uzm99/ENCE4231_UnaiZurbano/2026_PhilsLab_PCBDesign/BOM/2026_PhilsLab_PCBDesign.csv

Reference | Qty | Value | DNP | Exclude from BOM | Exclude from Board | Footprint | Datasheet
C1,C2,C3,C4,C9 | 5 | 100n |  |  |  | Capacitor_SMD:C_0805_2012Metric
C5 | 1 | 10u |  |  |  | Capacitor_SMD:C_0805_2012Metric
C6 | 1 | 10n |  |  |  | Capacitor_SMD:C_0805_2012Metric
C7,C8 | 2 | 1u |  |  |  | Capacitor_SMD:C_0805_2012Metric
C10,C11 | 2 | 10p |  |  |  | Capacitor_SMD:C_0805_2012Metric
C12,C13 | 2 | 22u |  |  |  | Capacitor_SMD:C_0805_2012Metric
D1 | 1 | RED |  |  |  | LED_SMD:LED_0603_1608Metric
FB1 | 1 | 120R |  |  |  | Inductor_SMD:L_0603_1608Metric
J1 | 1 | USB_B_Micro |  |  |  | Connector_USB:USB_Micro-B_Wuerth_629105150521
J2,J3,J4 | 3 | Conn_01x04_Pin |  |  |  | Connector_PinHeader_2.54mm:PinHeader_1x04_P2.54mm_Vertical
R1 | 1 | 10k |  |  |  | Resistor_SMD:R_0402_1005Metric
R2,R3,R4,R5 | 4 | 1k5 |  |  |  | Resistor_SMD:R_0402_1005Metric
SW1 | 1 | SW_SPDT |  |  |  | Button_Switch_SMD:SW_SPDT_PCM12
U1 | 1 | STM32F103C8T6 |  |  |  | Package_QFP:LQFP-48_7x7mm_P0.5mm | https://www.st.com/resource/en/datasheet/stm32f103c8.pdf
U2 | 1 | AMS1117-3.3 |  |  |  | Package_TO_SOT_SMD:SOT-223-3_TabPin2 | http://www.advanced-monolithic.com/pdf/ds1117.pdf
Y1 | 1 | 16MHz |  |  |  | Crystal:Crystal_SMD_3225-4Pin_3.2x2.5mm
