uzm99/ENCE4231_UnaiZurbano/2026_PhilsLab_PCBDesign/components/WE_629105150521_CAD_files/Download_IGES_629105150521 (rev1).iges

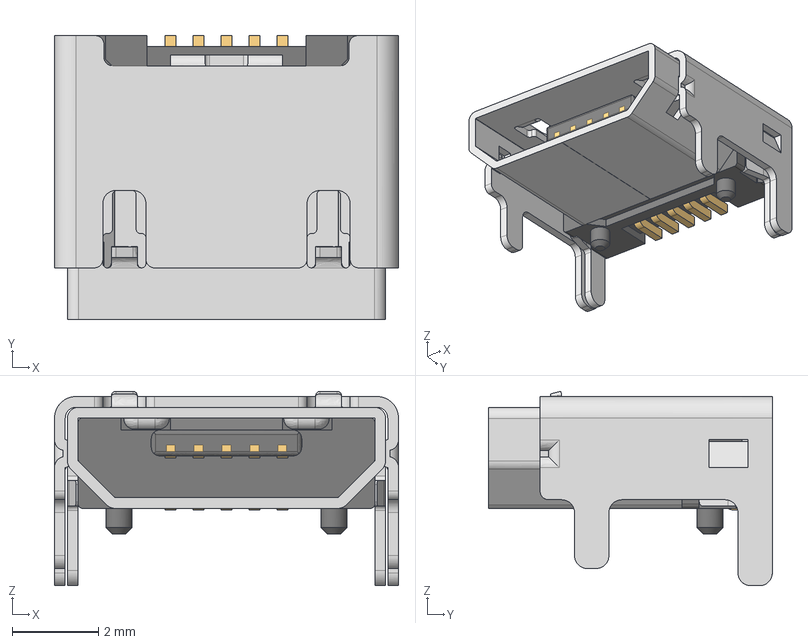
[picture p6: CAD file, 2026-04-28]
2026_PhilsLab_PCBDesign/components/WE_629105150521_CAD_files/Download_IGES_629105150521 (rev1).iges
8.00 x 6.60 x 4.52 mm
