uzm99/ENCE4231_UnaiZurbano/FinalProject_2WheelRobot/Projects/20260501_2Wheel_Balance_Robot/components/ESP8266-01_ESP-01/step/ESP8266-01_ESP-01.step

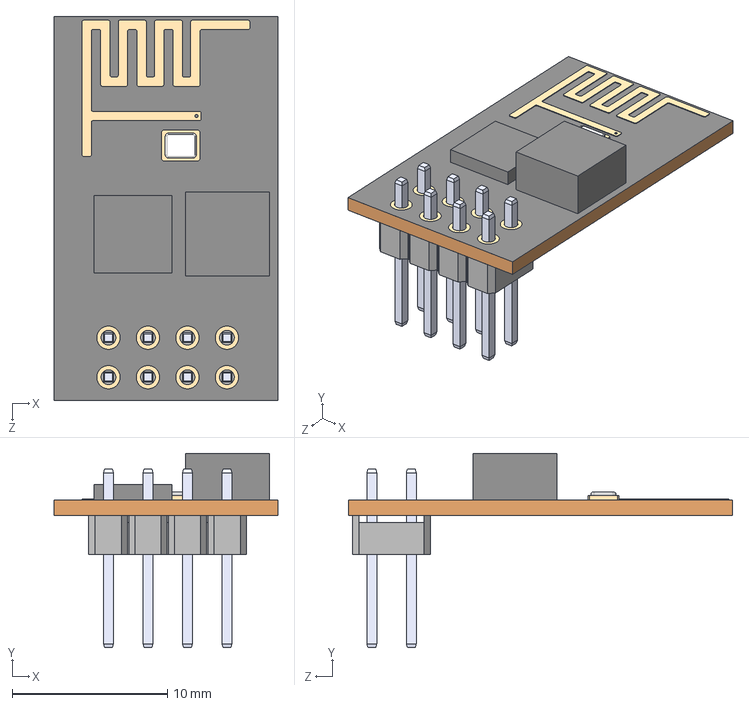
[picture p7: CAD file, 2026-04-23]
FinalProject_2WheelRobot/Projects/20260501_2Wheel_Balance_Robot/components/ESP8266-01_ESP-01/step/ESP8266-01_ESP-01.step
14.4 x 12.5 x 24.7 mm
