uzm99/ENCE4231_UnaiZurbano/FinalProject_2WheelRobot/Projects/20260501_2Wheel_Balance_Robot/components/Fuse_3DModel/MF-MSMF050-2--3DModel-STEP-56544.STEP

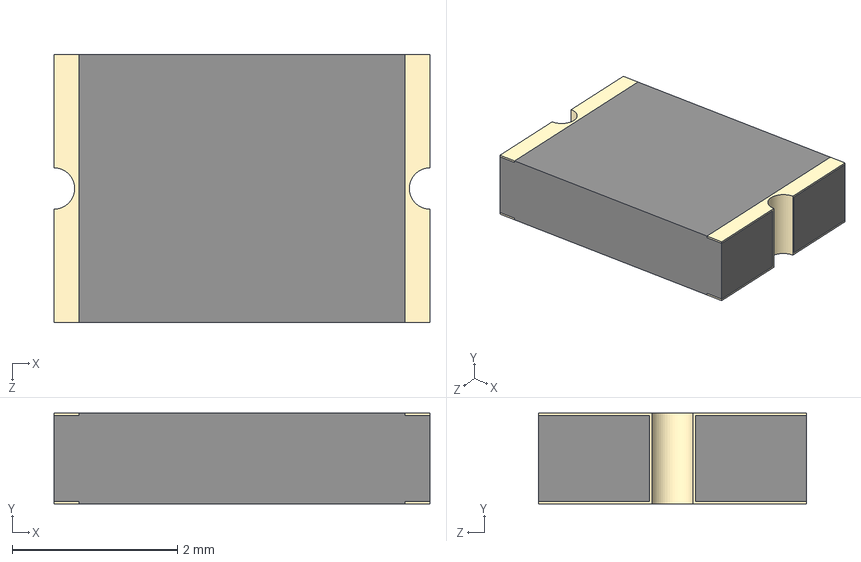
[picture p8: CAD file, 2026-04-23]
FinalProject_2WheelRobot/Projects/20260501_2Wheel_Balance_Robot/components/Fuse_3DModel/MF-MSMF050-2--3DModel-STEP-56544.STEP
4.55 x 1.10 x 3.24 mm
