uzm99/ENCE4231_UnaiZurbano/FinalProject_2WheelRobot/Projects/20260501_2Wheel_Balance_Robot/components/MPU6050/ITG-MPU.STEP

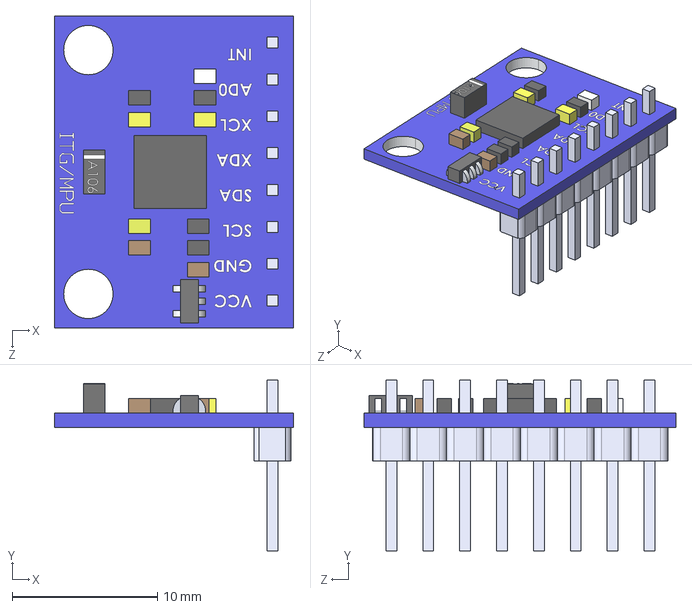
[picture p9: CAD file, 2026-04-23]
FinalProject_2WheelRobot/Projects/20260501_2Wheel_Balance_Robot/components/MPU6050/ITG-MPU.STEP
16.5 x 11.8 x 21.5 mm
8 Header-Pin
Placa_Base
