uzm99/ENCE4231_UnaiZurbano/FinalProject_2WheelRobot/Projects/20260501_2Wheel_Balance_Robot/components/SPDT_Slide_Switch/step/SLW-66527511-SMT-TR.step

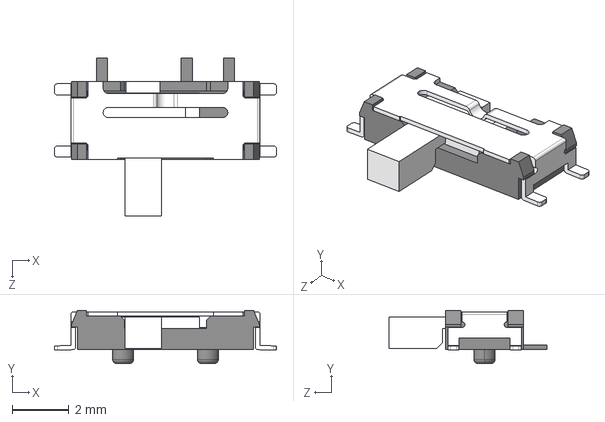
[picture p10: CAD file, 2026-04-23]
FinalProject_2WheelRobot/Projects/20260501_2Wheel_Balance_Robot/components/SPDT_Slide_Switch/step/SLW-66527511-SMT-TR.step
7.86 x 1.88 x 5.58 mm
