uzm99/ENCE4231_UnaiZurbano/FinalProject_2WheelRobot/Projects/20260501_2Wheel_Balance_Robot/components/SW_uP_Reset/step/SW_uP_Reset.stp

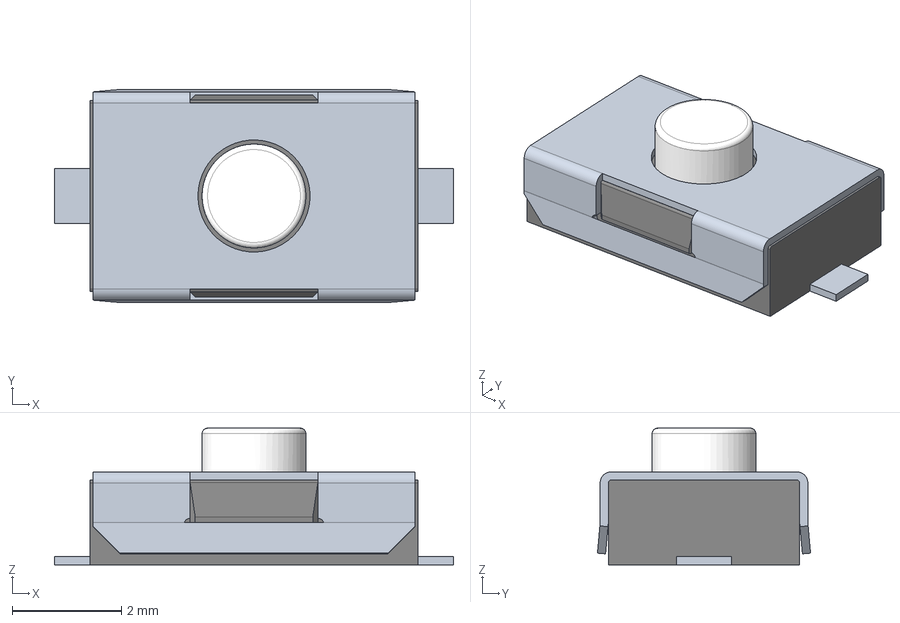
[picture p11: CAD file, 2026-04-23]
FinalProject_2WheelRobot/Projects/20260501_2Wheel_Balance_Robot/components/SW_uP_Reset/step/SW_uP_Reset.stp
7.30 x 3.90 x 2.50 mm
