uzm99/ENCE4231_UnaiZurbano/FinalProject_2WheelRobot/Projects/20260501_2Wheel_Balance_Robot/components/USB_C/step/Same_Sky_UJ20-C-H-C-4-SMT-TR.step

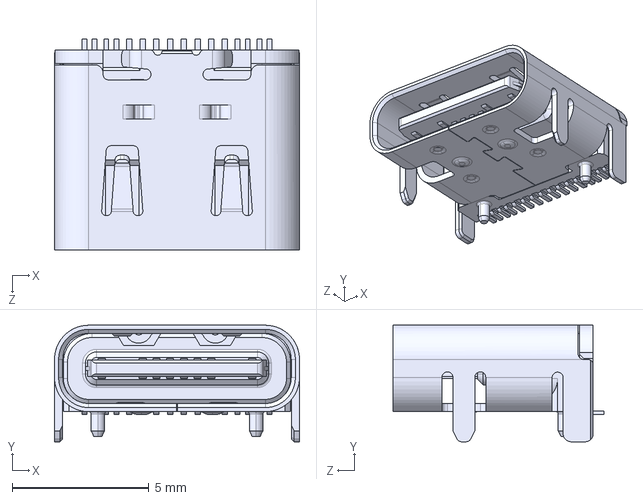
[picture p12: CAD file, 2026-04-30]
FinalProject_2WheelRobot/Projects/20260501_2Wheel_Balance_Robot/components/USB_C/step/Same_Sky_UJ20-C-H-C-4-SMT-TR.step
8.95 x 4.26 x 7.72 mm
