uzm99/ENCE4231_UnaiZurbano/(list of files, cad)

Other CAD files:
2026_PhilsLab_PCBDesign/components/WE_629105150521_CAD_files/629105150521 (rev1).stp
