uzm99/ENCE4231_UnaiZurbano/FinalProject_2WheelRobot/IMG/JST_soldered_encoder.jpeg

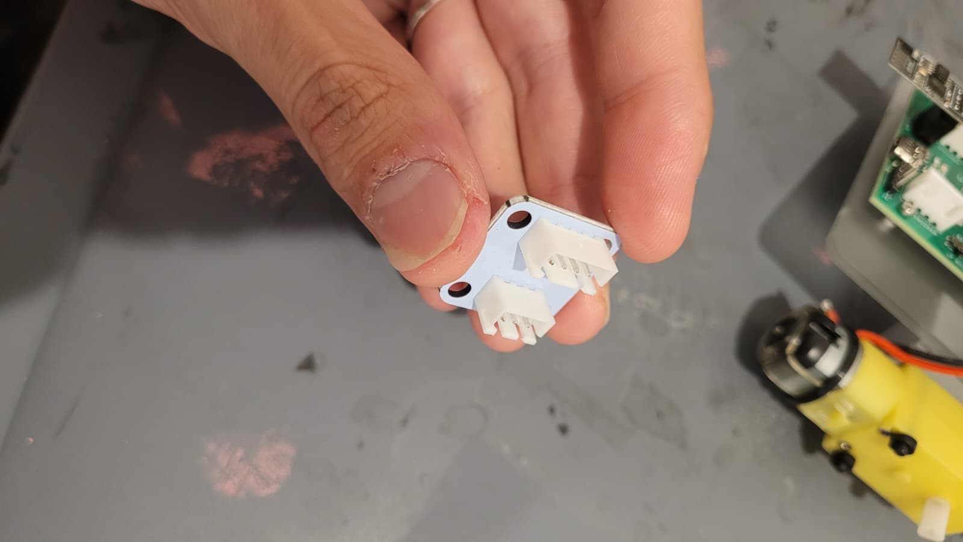
FinalProject_2WheelRobot/IMG/JST_soldered_encoder.jpeg
