uzm99/ENCE4231_UnaiZurbano/FinalProject_2WheelRobot/Projects/20260501_2Wheel_Balance_Robot/docs/20260501_Print PCB_Rev2.0.pdf

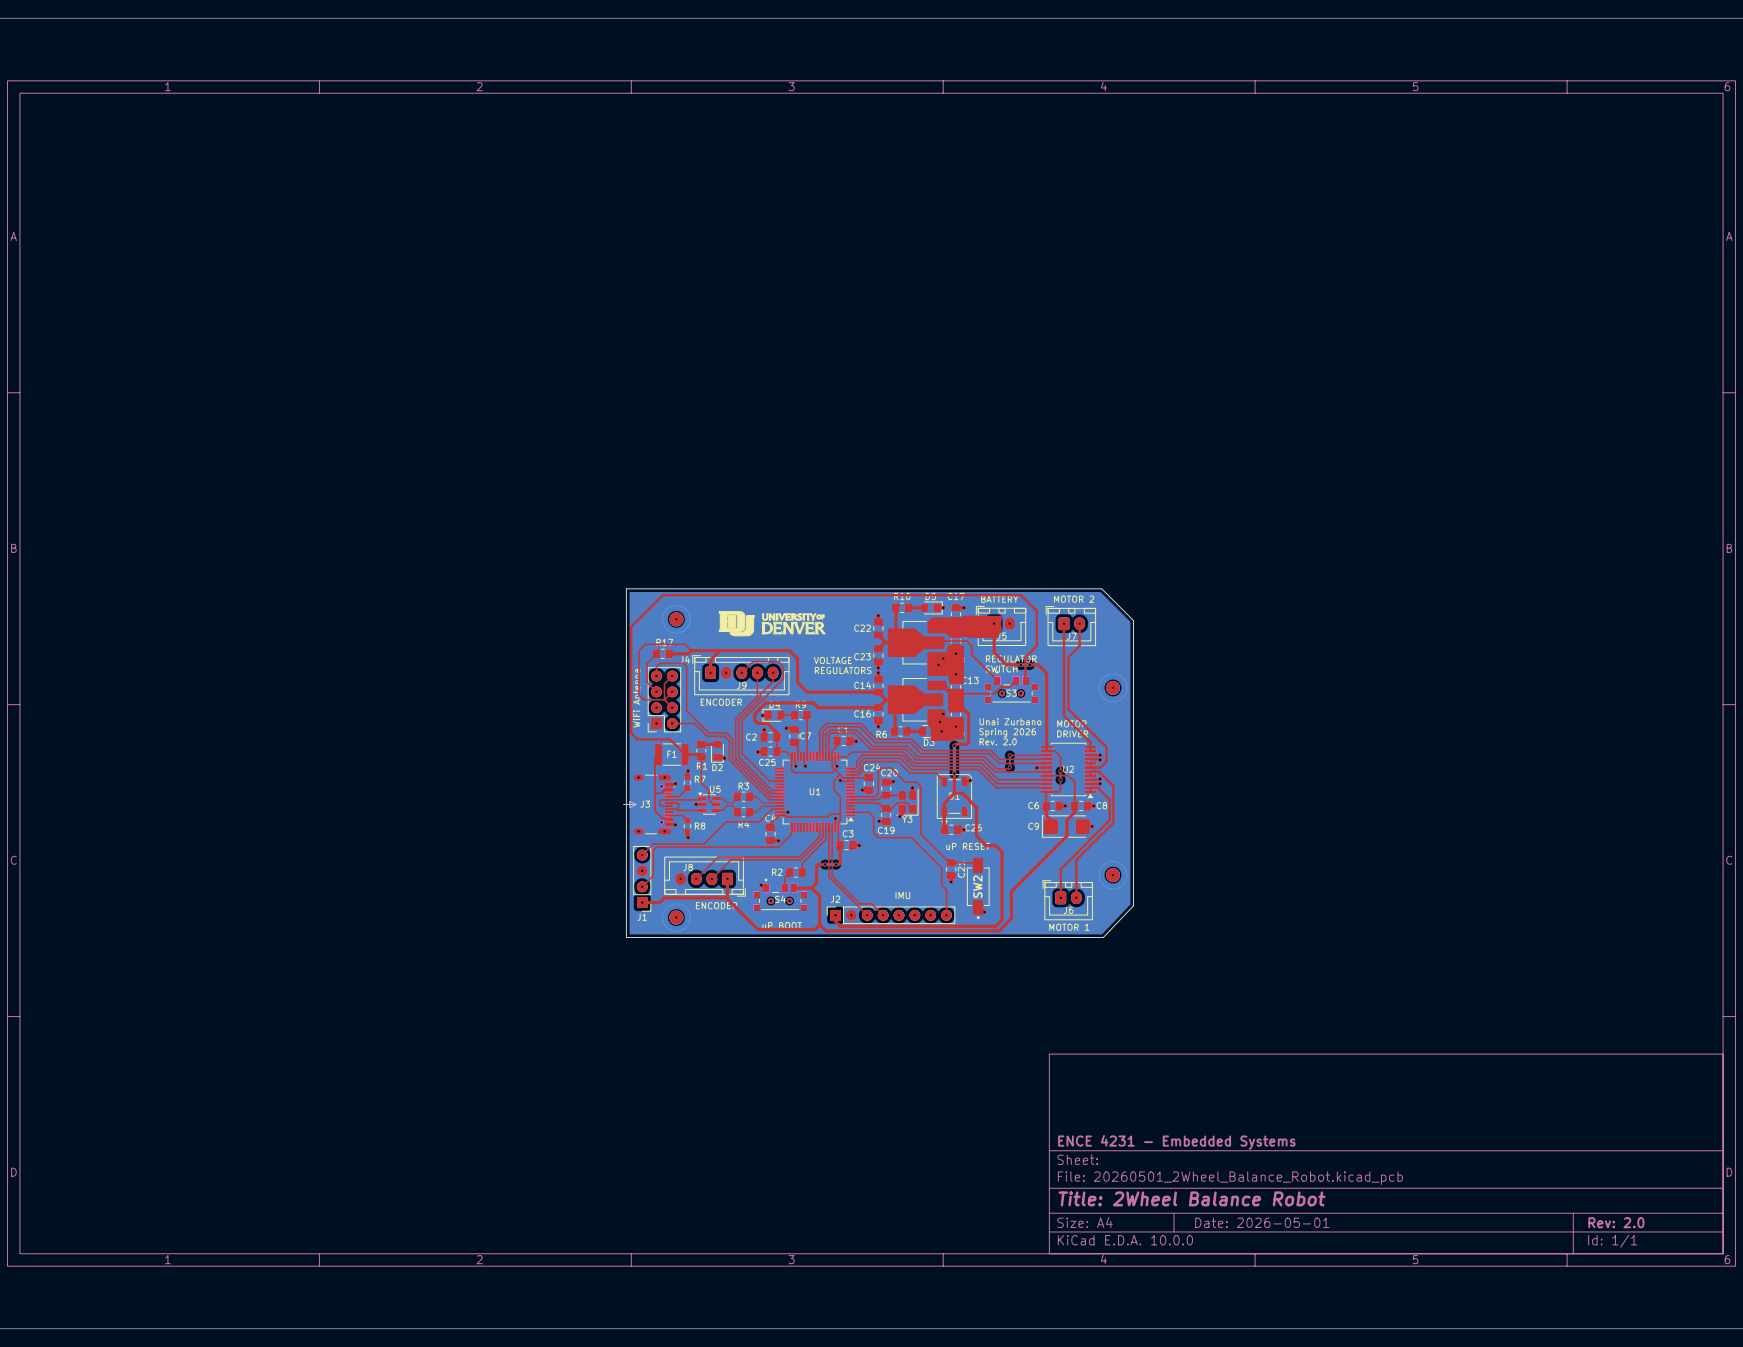
[picture p14: page 1]
