uzm99/ENCE4231_UnaiZurbano/FinalProject_2WheelRobot/Projects/20260501_2Wheel_Balance_Robot/docs/20260423_Print Schematic.pdf

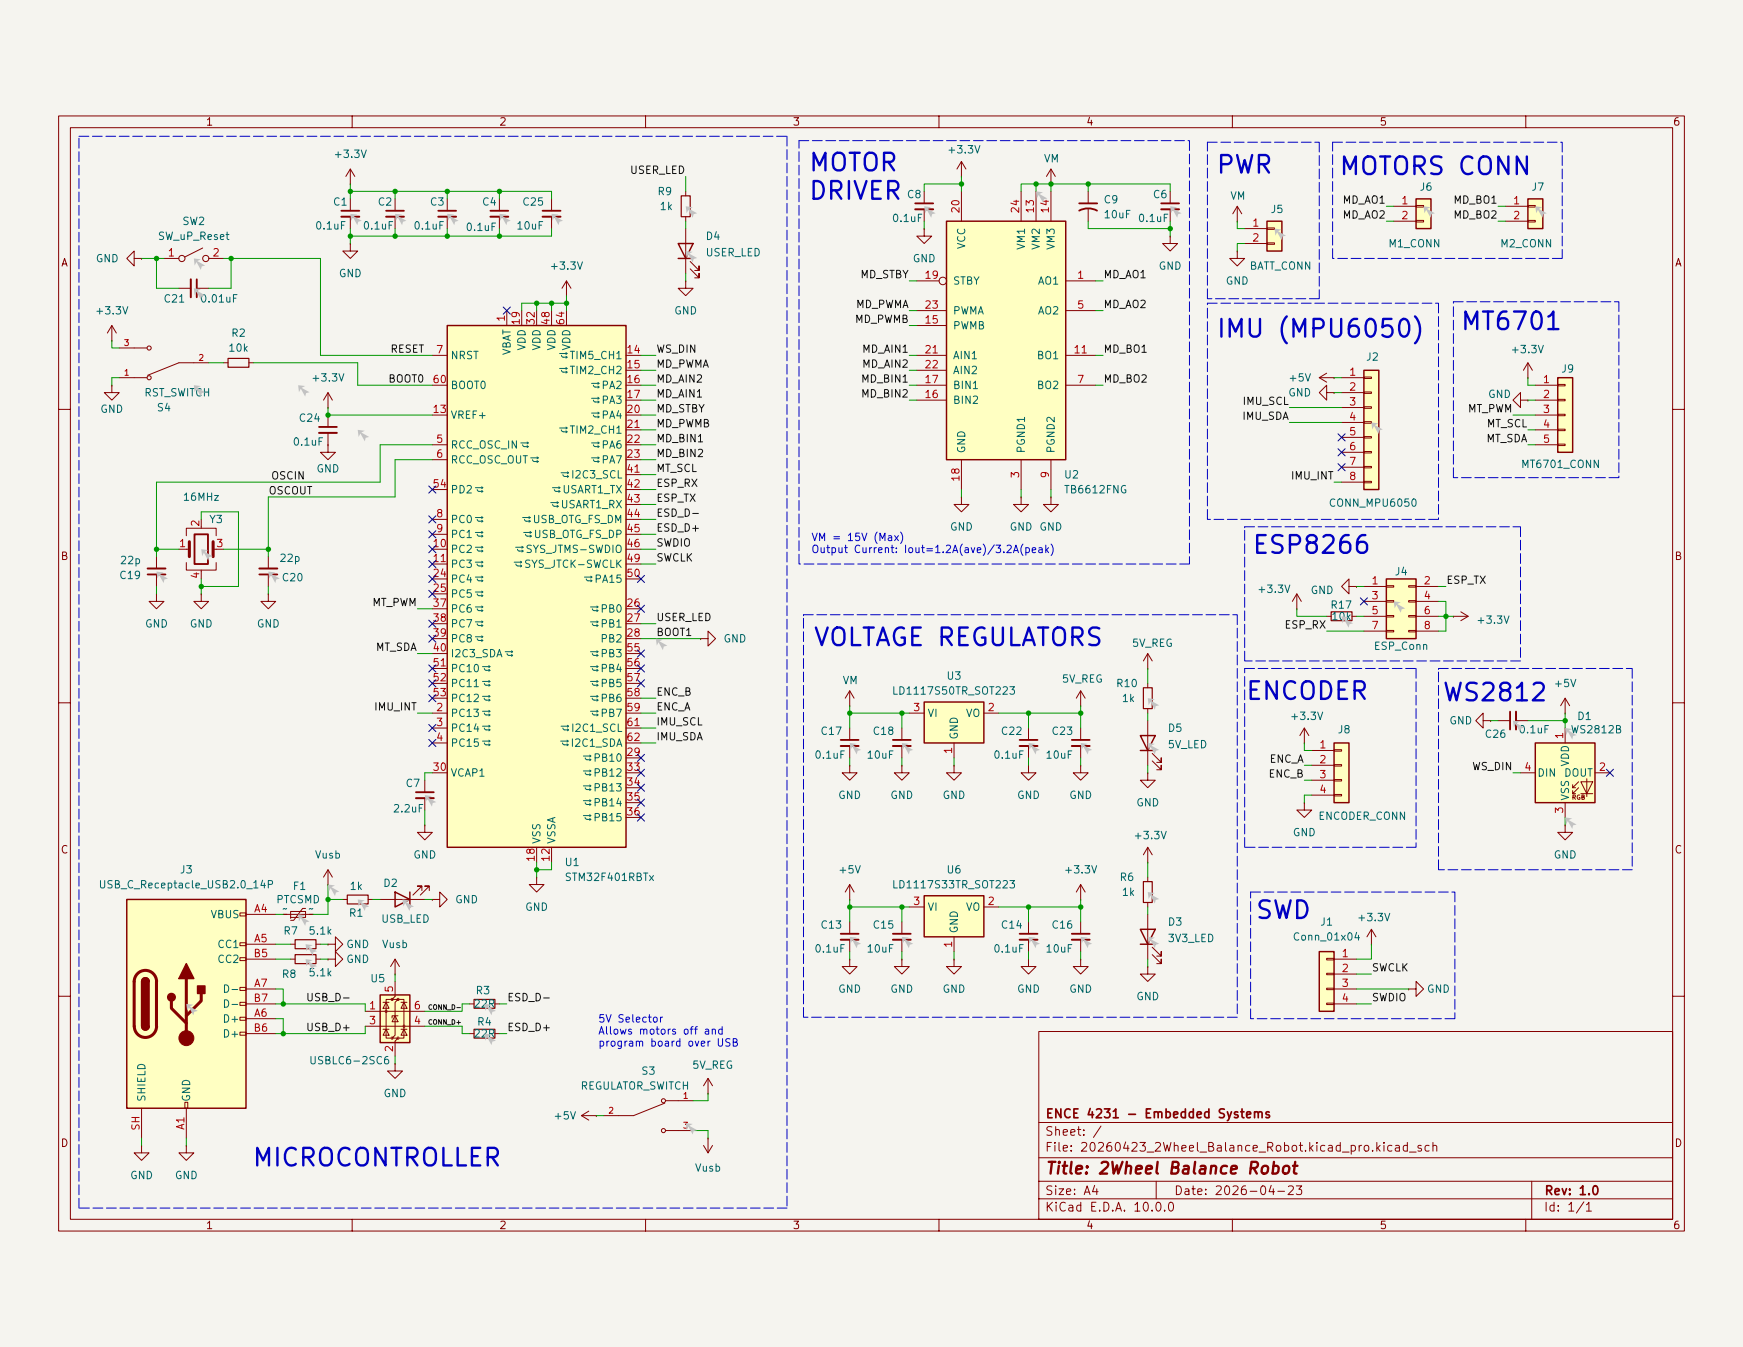
[picture p15: page 1]
