uzm99/ENCE4231_UnaiZurbano/FinalProject_2WheelRobot/Projects/2026_InClass_2Wheel_Robot_kicad/docs/20260423_1300_Print Schematic.pdf

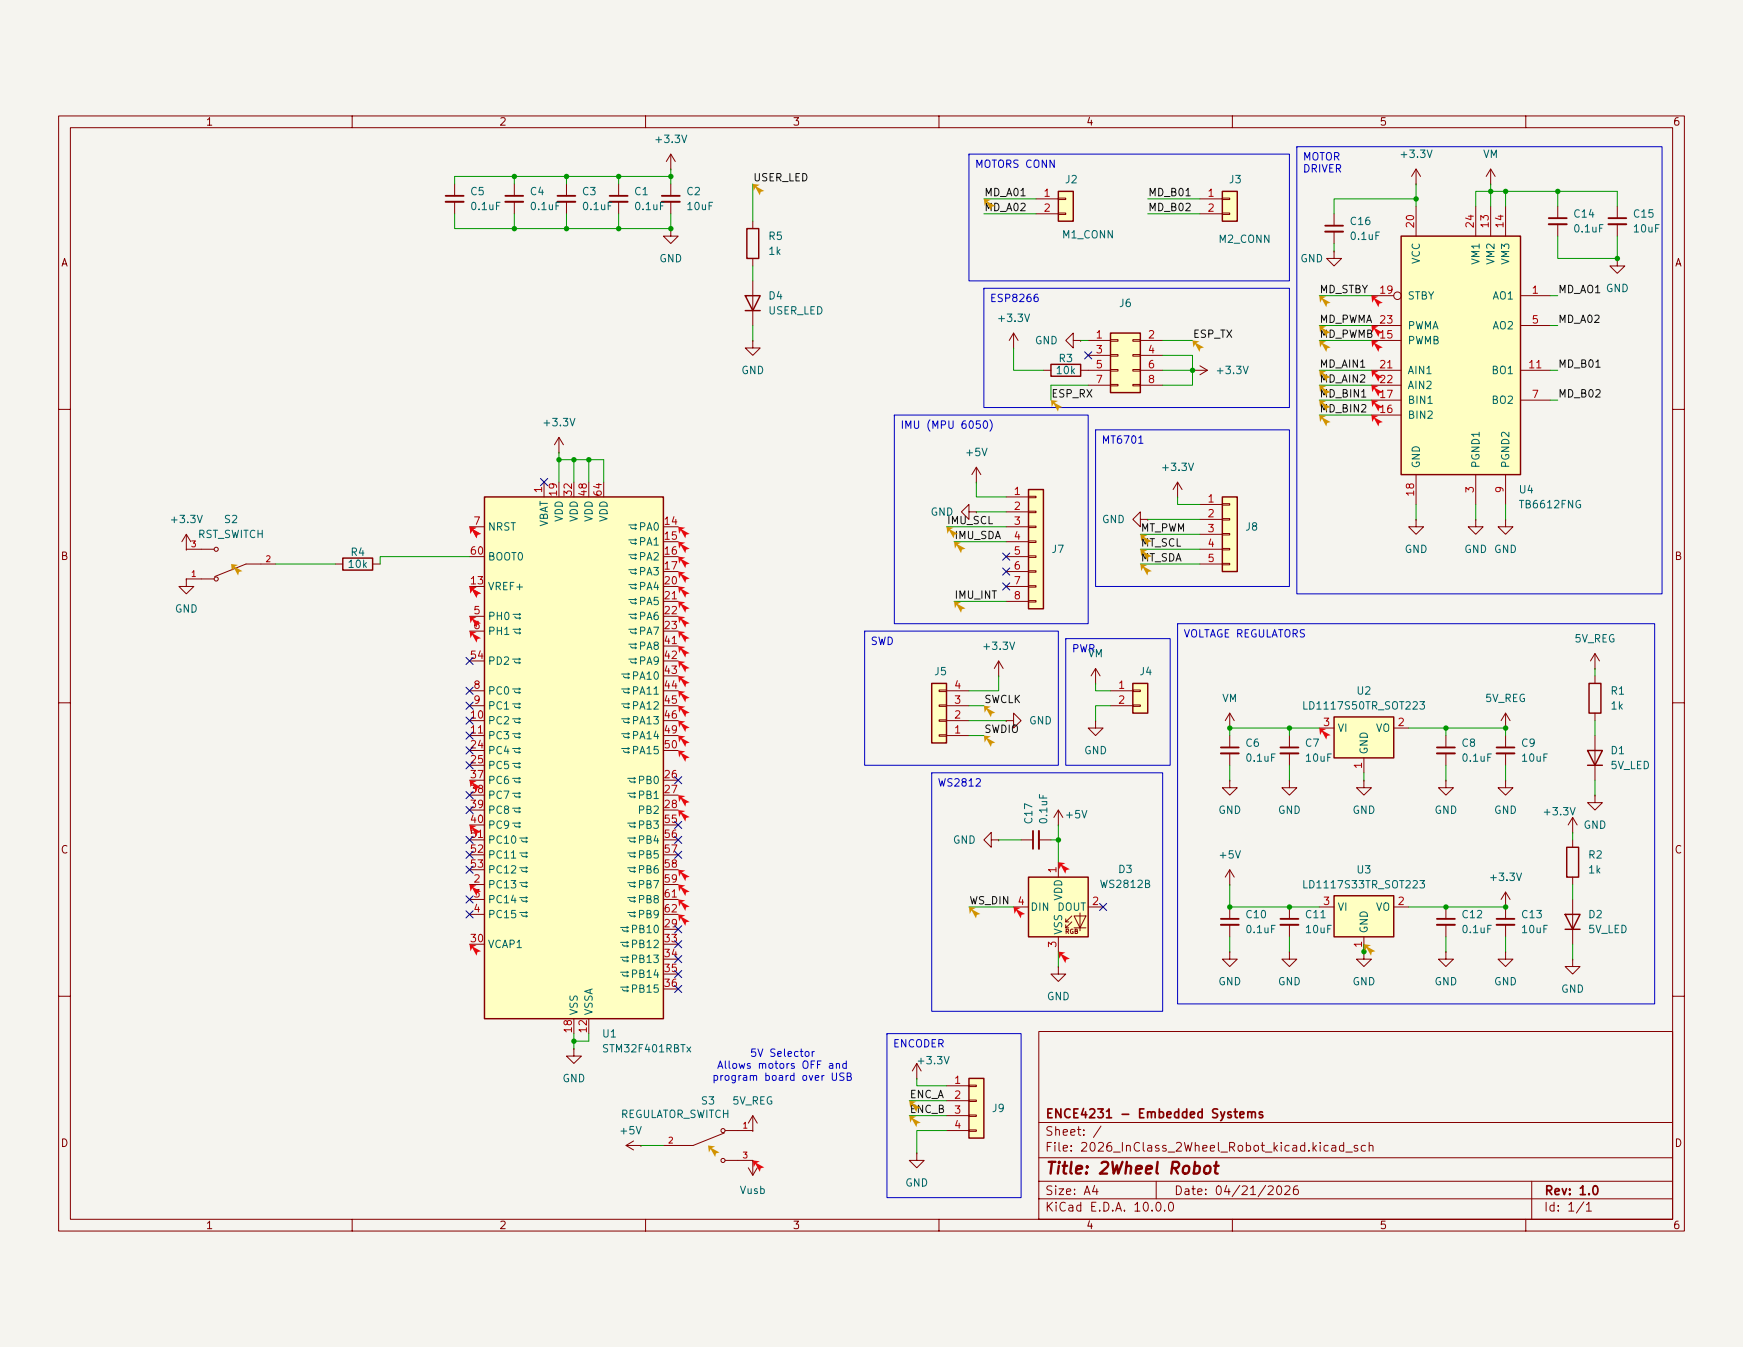
[picture p17: page 1]
