uzm99/ENCE4231_UnaiZurbano/FinalProject_2WheelRobot/Projects/2026_InClass_2Wheel_Robot_kicad/2026_InClass_2Wheel_Robot_kicad.kicad_pcb

## KiCad design FinalProject_2WheelRobot/Projects/2026_InClass_2Wheel_Robot_kicad/2026_InClass_2Wheel_Robot_kicad.kicad_pcb (2026-04-23)

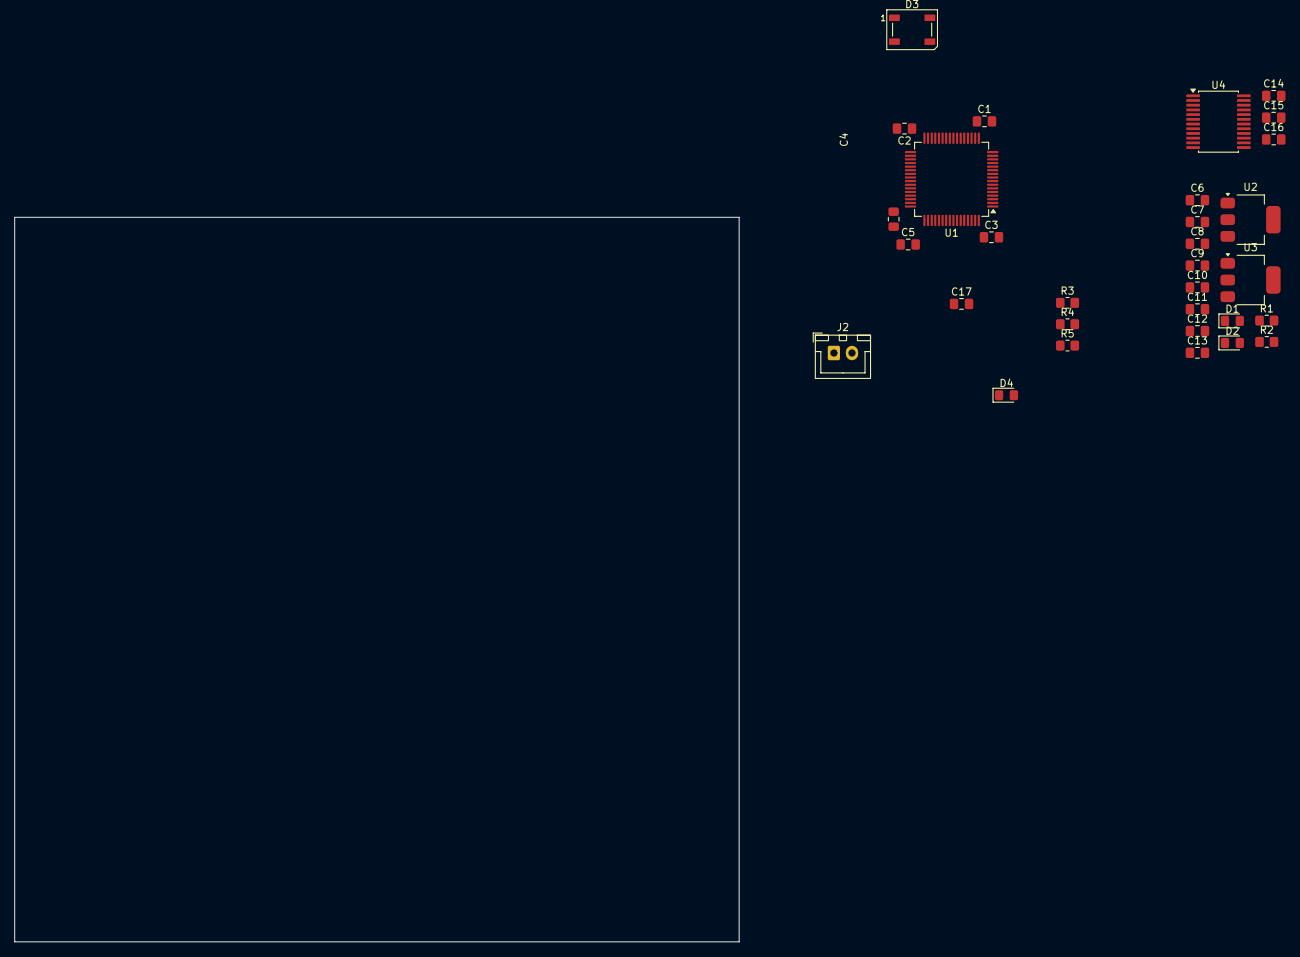
[picture p22: board 2026_InClass_2Wheel_Robot_kicad.kicad_pcb from above]

Board: 2 copper layers, 100.0 x 100.0 mm, 31 parts (0 on the bottom side), 14 nets, no tracks yet.

Parts:
C1, C3, C4, C5, C6, C8, C10, C12, C14, C16, C17: 0.1uF; C_0805_2012Metric_Pad1.18x1.45mm_HandSolder
C2, C7, C9, C11, C13, C15: 10uF; C_0805_2012Metric_Pad1.18x1.45mm_HandSolder
D1, D2: 5V_LED; LED_0805_2012Metric_Pad1.15x1.40mm_HandSolder
D3: WS2812B; LED_WS2812B_PLCC4_5.0x5.0mm_P3.2mm
D4: USER_LED; LED_0805_2012Metric_Pad1.15x1.40mm_HandSolder
J2: JST_XH_B2B-XH-A_1x02_P2.50mm_Vertical
R1, R2, R5: 1k; R_0805_2012Metric_Pad1.20x1.40mm_HandSolder
R3, R4: 10k; R_0805_2012Metric_Pad1.20x1.40mm_HandSolder
U1: STM32F401RBTx; LQFP-64_10x10mm_P0.5mm
U2: LD1117S50TR_SOT223; SOT-223-3_TabPin2
U3: LD1117S33TR_SOT223; SOT-223-3_TabPin2
U4: TB6612FNG; SSOP-24_5.3x8.2mm_P0.65mm

Connections:
5V_REG: C8.1, C9.1, R1.1, U2.2 (VO)
+3.3V: C1.1, C2.1, C3.1, C4.1, C5.1, C12.1, C13.1, C16.1, R2.1, R3.2, U1.19 (VDD), U1.32 (VDD), U1.48 (VDD), U1.64 (VDD), U3.2 (VO), U4.20 (VCC)
+5V: C10.1, C11.1, C17.2, D3.1 (VDD), U3.3 (VI)
/MD_A02: J2.2, U4.5 (AO2), U4.6 (AO2)
/MD_AO1: U4.1 (AO1), U4.2 (AO1)
/MD_B01: U4.11 (BO1), U4.12 (BO1)
/MD_B02: U4.7 (BO2), U4.8 (BO2)
GND: C1.2, C2.2, C3.2, C4.2, C5.2, C6.2, C7.2, C8.2, C9.2, C10.2, C11.2, C12.2, C13.2, C14.2, C15.2, C16.2, C17.1, D1.1 (K), D2.1 (K), D3.3 (VSS), D4.1 (K), U2.1 (GND), U3.1 (GND), U4.3 (PGND1), U4.4 (PGND1), U4.9 (PGND2), U4.10 (PGND2), U4.18 (GND)
unnamed: D1.2 (A), R1.2
unnamed: D2.2 (A), R2.2
unnamed: D4.2 (A), R5.2
unnamed: R4.1, U1.60 (BOOT0)
unnamed: U1.18 (VSS), U1.31 (VSS), U1.47 (VSS), U1.63 (VSS)
VM: C6.1, C7.1, C14.1, C15.1, U2.3 (VI), U4.13 (VM2), U4.14 (VM3), U4.24 (VM1)
